leeuz/Autonomous-Object-Seeking-and-Picking-Robot/(commit log)

2026-01-05 Create Ultrasonic_Sensors_Test_Code.ino
    Created the code to test if 3 ultrasonic sensors can give one accurate location (distance) of an object.
2026-01-05 Create ToF_Sensor_Test_Code.ino
    To test the distance range and accurateness of the ToF sensor.
2026-01-12 base cad design
2026-01-12 Created Base CAD Design
2026-01-12 Created Gripper CAD Design
2026-01-12 Created Wiring Diagram
2026-01-12 Created logic flowchart
2026-01-13 video of demo with gripper
